XuDank/AutoMic/CAD & f3d Files/Schematic Diagram.png

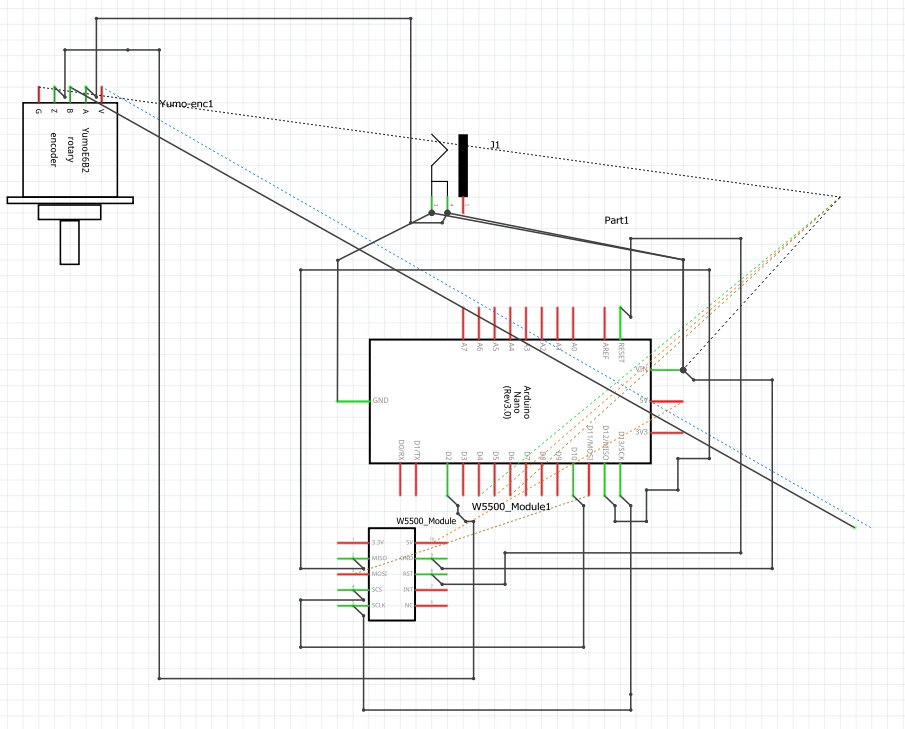
CAD & f3d Files/Schematic Diagram.png
