XuDank/AutoMic/(list of files, cad)

Other CAD files:
CAD & f3d Files/Box Mount v17.f3z
CAD & f3d Files/Mic Placements v4.f3d
CAD & f3d Files/NanoEthernetShield v1.f3d
CAD & f3d Files/NanoV3 v4 v1.f3d
CAD & f3d Files/Reel v11.f3d
CAD & f3d Files/Reel v4.f3d
CAD & f3d Files/Stage v1.f3d
CAD & f3d Files/Stage v18.f3d
