XuDank/AutoMic/(list of files, drawings)

Other design files:
CAD & f3d Files/AutoMic.fzz
