XuDank/AutoMic/CAD & f3d Files/Wiring Diagram.png

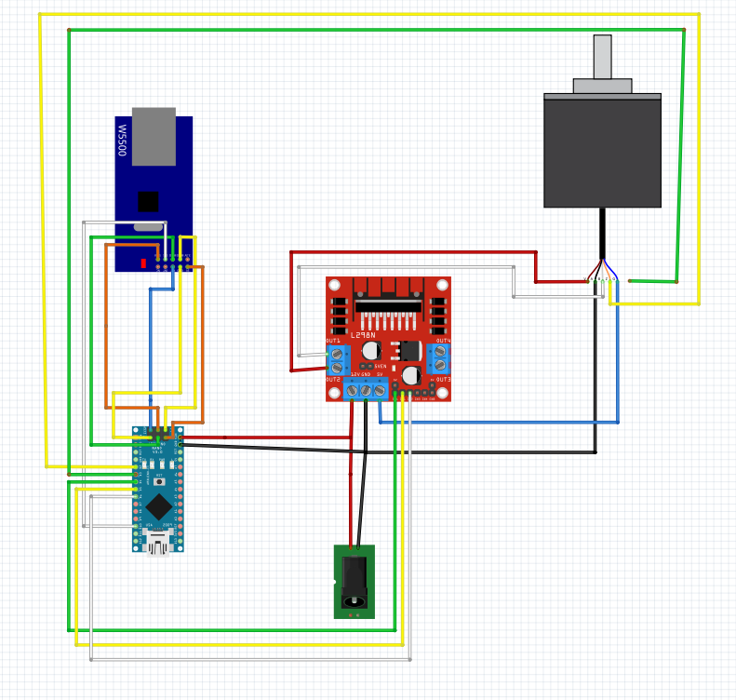
CAD & f3d Files/Wiring Diagram.png
