XuDank/AutoMic/python-server/testing/reliability/15.csv

 | Measured Error (in cm)
0 | -0.2414843587795712
1 | -0.2224444033032693
2 | -0.16532453687436366
3 | -0.16532453687436366
4 | -0.10820467044545978
