XuDank/AutoMic/python-server/testing/reliability/5.csv

 | Measured Error (in cm)
0 | -0.7119866428905324
1 | -0.7500665538431361
