XuDank/AutoMic/python-server/testing/reliability/reliability.csv

 | Measured Length (in cm)
0 | 5.949986086344305
1 | 5.959506064082456
