XuDank/AutoMic/python-server/testing/accuracy/10cm.png

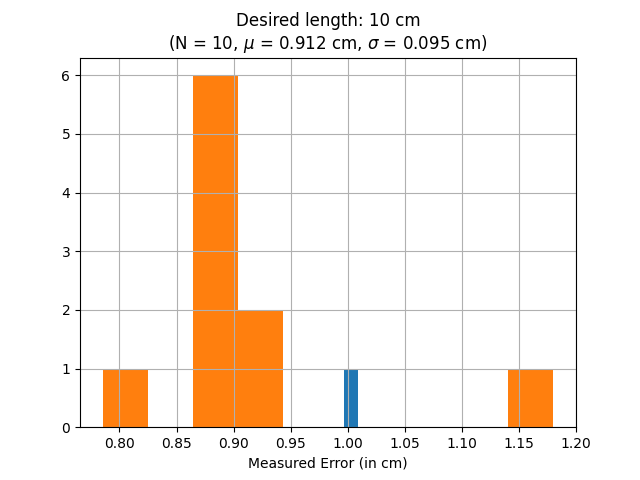
python-server/testing/accuracy/10cm.png
