XuDank/AutoMic/python-server/testing/pid/P10I00D00.png

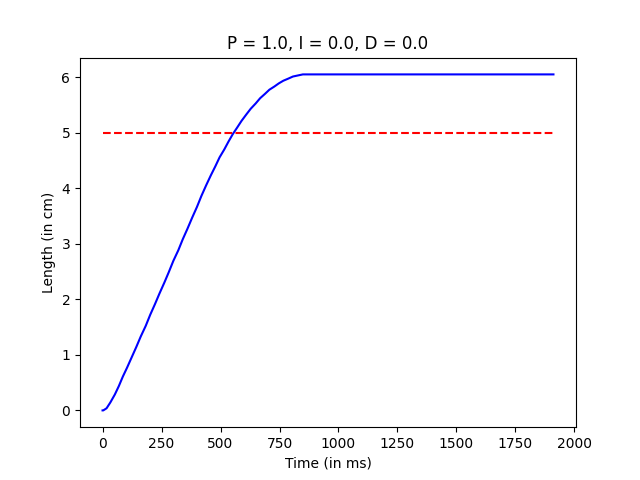
python-server/testing/pid/P10I00D00.png
