XuDank/AutoMic/python-server/testing/pid/P15I00D10.png

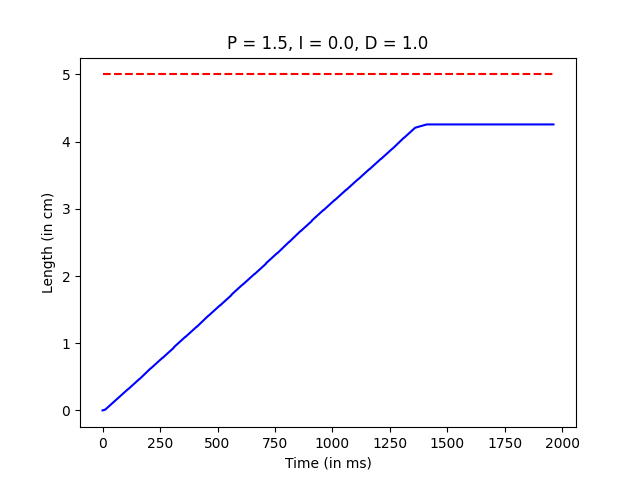
python-server/testing/pid/P15I00D10.png
