XuDank/AutoMic/python-server/testing/pid/P20I00D00.png

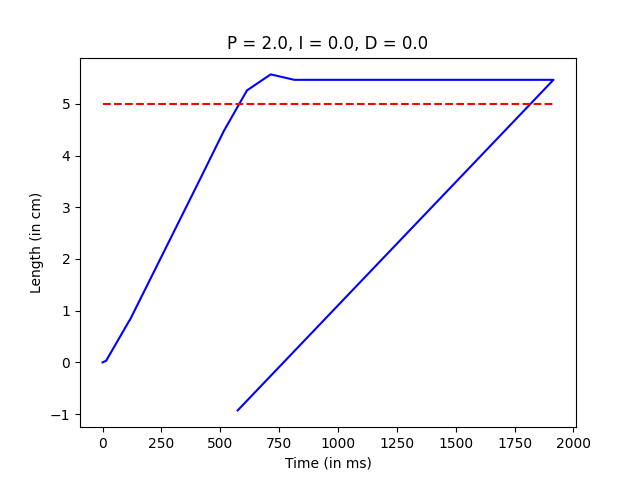
python-server/testing/pid/P20I00D00.png
