XuDank/AutoMic/python-server/testing/pid/P20I00D01.png

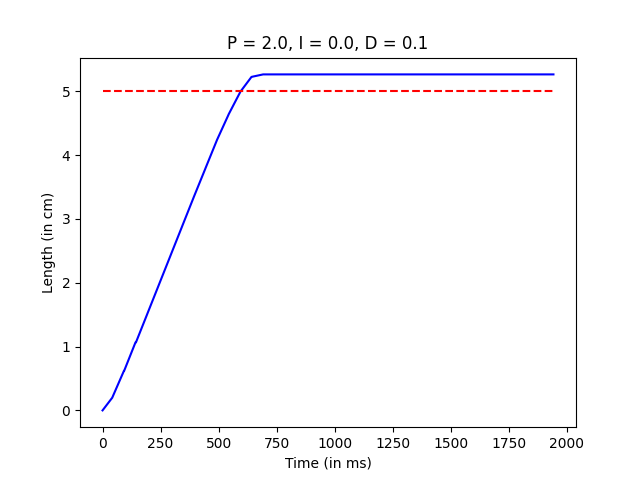
python-server/testing/pid/P20I00D01.png
