XuDank/AutoMic/python-server/testing/pid/P20I00D10.png

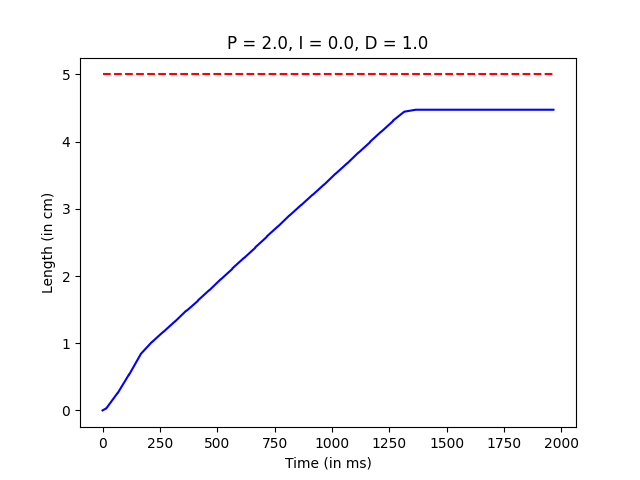
python-server/testing/pid/P20I00D10.png
