XuDank/AutoMic/python-server/testing/pid/P30I20D001.png

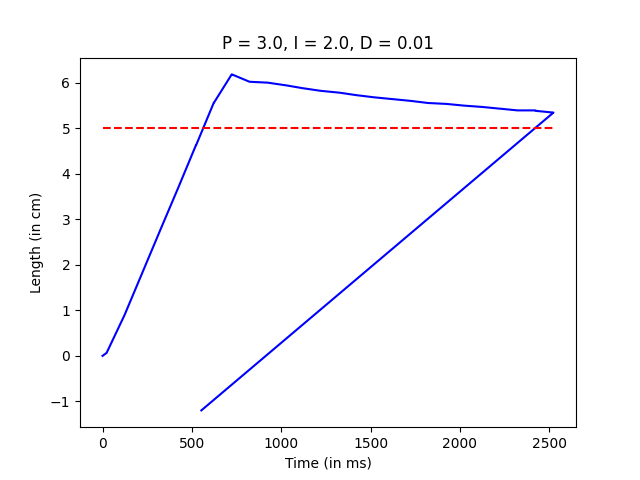
python-server/testing/pid/P30I20D001.png
