XuDank/AutoMic/python-server/testing/pid/P40I00D00.png

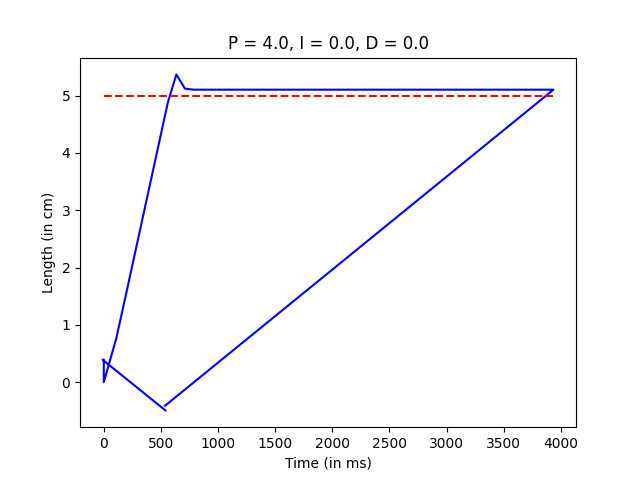
python-server/testing/pid/P40I00D00.png
