XuDank/AutoMic/python-server/testing/pid/P50I00D00.png

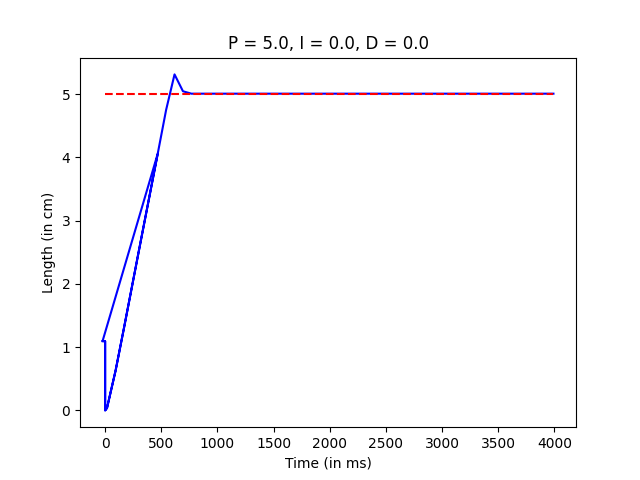
python-server/testing/pid/P50I00D00.png
