XuDank/AutoMic/python-server/testing/pid/P50I01D001.png

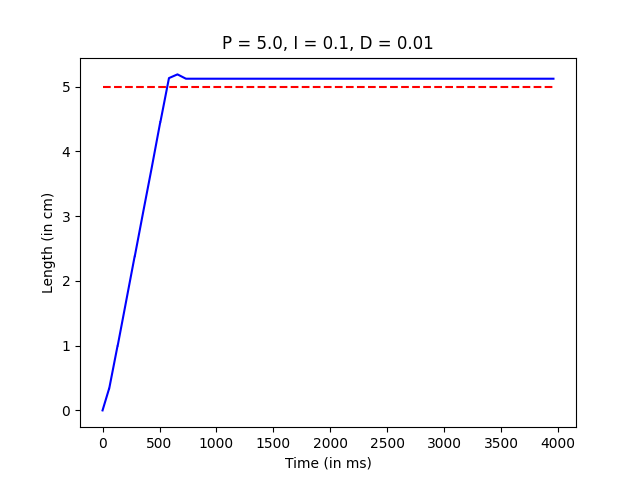
python-server/testing/pid/P50I01D001.png
