XuDank/AutoMic/python-server/testing/reliability/0cm.png

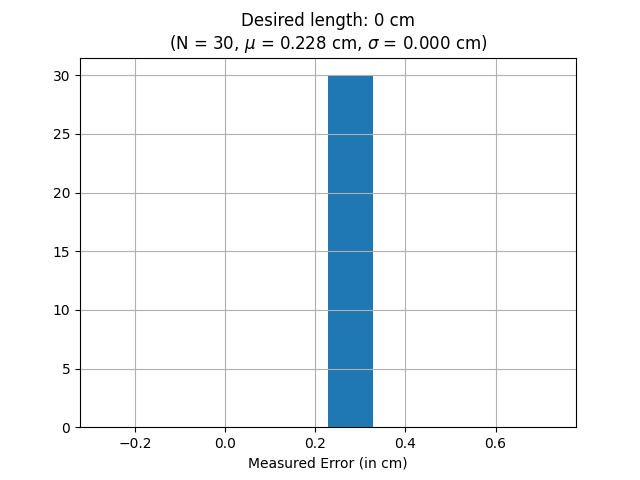
python-server/testing/reliability/0cm.png
