XuDank/AutoMic/python-server/testing/reliability/5cm.png

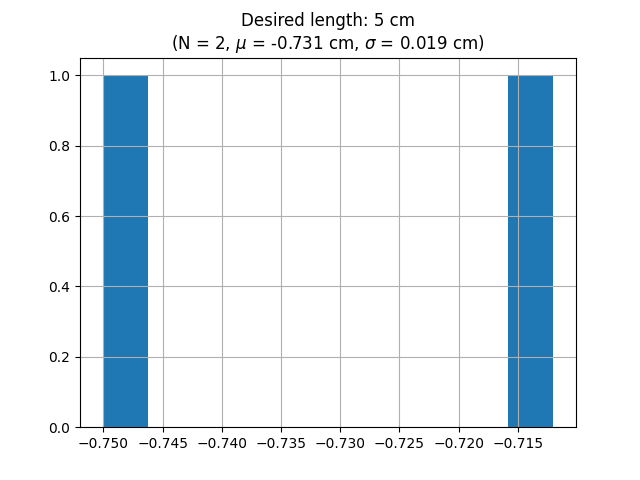
python-server/testing/reliability/5cm.png
