XuDank/AutoMic/python-server/testing/reliability/10cm.png

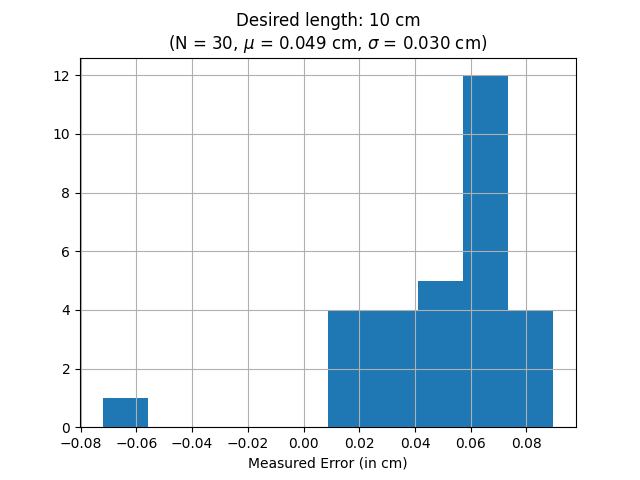
python-server/testing/reliability/10cm.png
