XuDank/AutoMic/python-server/testing/reliability/15cm.png

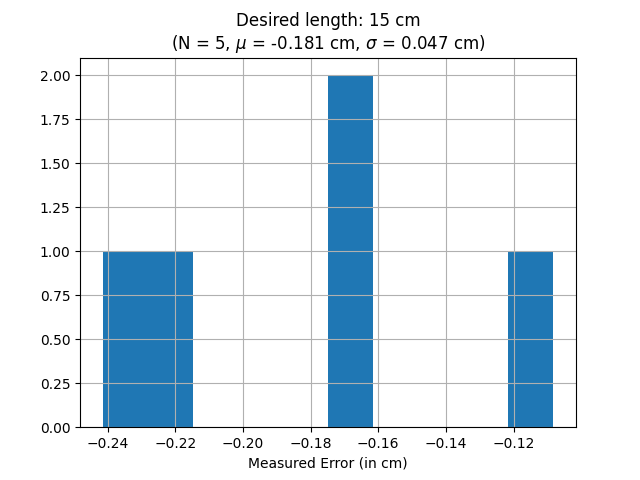
python-server/testing/reliability/15cm.png
