XuDank/AutoMic/python-server/testing/screenshots/genuino_setup_test.png

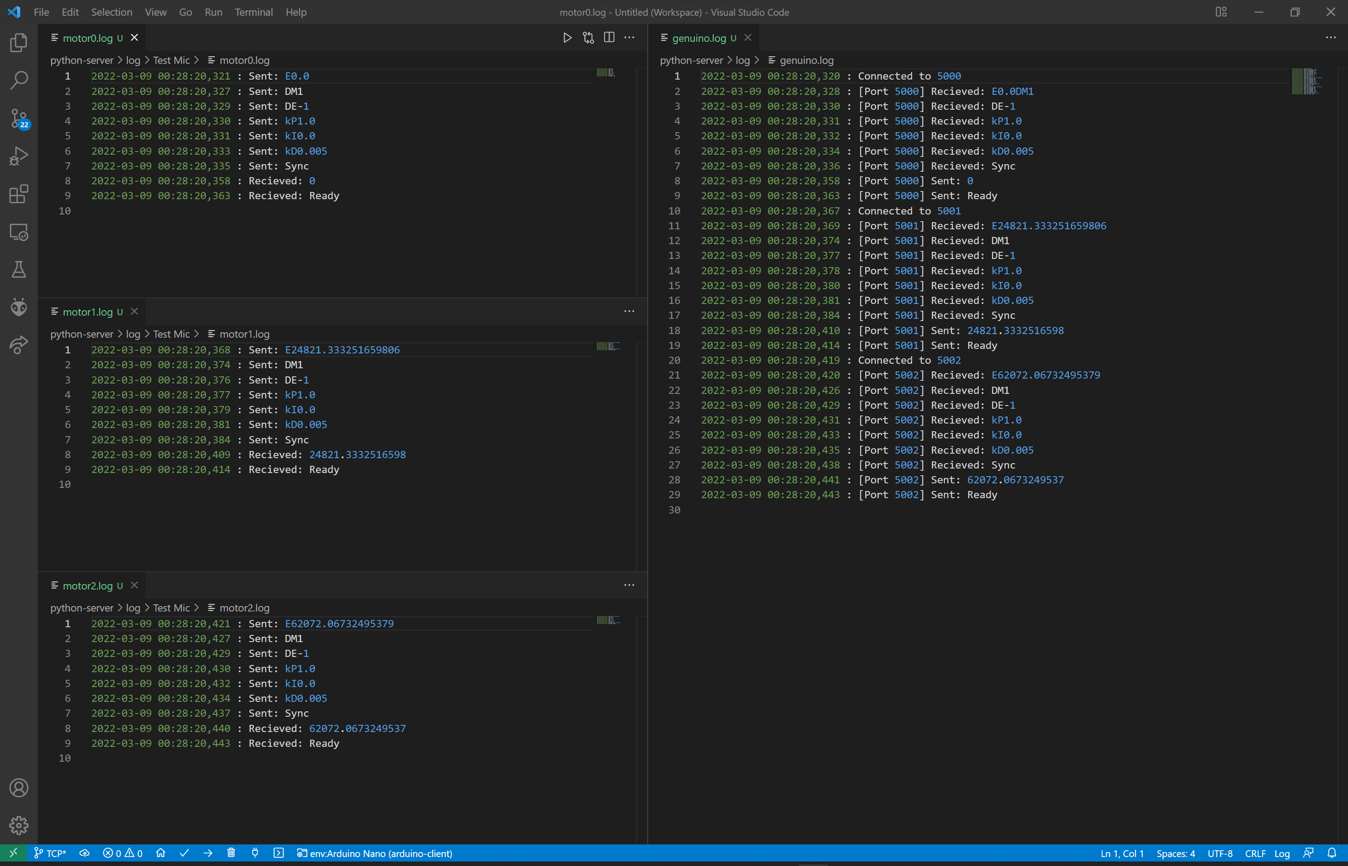
python-server/testing/screenshots/genuino_setup_test.png
