XuDank/AutoMic/(commit log)

2022-01-11 Tension calculation on jupyter
2022-02-09 bug fixes
    [Box Mount v17.f3z]
2022-02-14 bug fixes two motors working
